kyriazisn/routine-quest/docs/03-wireframes.md

# 03 — Wireframes (Parent PWA & Device UI)

Status: **Draft — προς έγκριση**

Figma: https://www.figma.com/design/BA38FGH2zqvsLxBvpiYlAG

Low-fidelity wireframes: γκρι παλέτα, Inter, mobile frame 390×844. Τα χρώματα που εμφανίζονται είναι μόνο τα χρώματα των βημάτων και των LEDs, επειδή αποτελούν μέρος του concept.

## Σελίδες

| Σελίδα | Περιεχόμενο |
|---|---|
| Parent PWA | Components, Onboarding (O1–O5), Core (C1–C6) |
| Device UI | `Device` component, 7 καταστάσεις (D1–D7) |

## Local components

| Component | Χρήση |
|---|---|
| `Button/Primary`, `Button/Secondary` | Κύριες και δευτερεύουσες ενέργειες |
| `AppBar` | Πάνω μπάρα με leading εικονίδιο ή «←» |
| `TabBar` | Σήμερα · Ιστορικό · Rewards · Ρυθμίσεις |
| `ListRow` | Γραμμή λίστας με εικονίδιο, τίτλο, υπότιτλο, trailing |
| `Field` | Πεδίο φόρμας |
| `Card` | Κάρτα κειμένου |
| `StepDot` | Βήμα quest: χρωματιστός κύκλος + εικονίδιο |
| `Annotation` | Κίτρινη σημείωση σχεδιασμού κάτω από κάθε οθόνη |
| `Device` | Κάτοψη συσκευής: ring 12 LEDs + 4 κουμπιά |

Όταν στηθεί το design system, αυτά θα αντιστοιχηθούν σε components της PWA μέσω Code Connect.

## Parent PWA

### Onboarding

| # | Οθόνη | Βασική απόφαση |
|---|---|---|
| O1 | Καλωσόρισμα | Passwordless magic link. Λογαριασμός μόνο για ενήλικες |
| O2 | Εγκατάσταση & ειδοποιήσεις | Στο iOS: «Προσθήκη στην οθόνη Αφετηρίας» πριν το permission για Web Push |
| O3 | Σύνδεση συσκευής | Web Bluetooth. Fallback SoftAP `RQ-xxxx` για iOS Safari |
| O4 | Wi-Fi | Τα credentials πηγαίνουν μόνο στη συσκευή. Λίστα δικτύων από scan της συσκευής |
| O5 | Παιδί & πρώτα quests | Μόνο ψευδώνυμο + avatar. Έτοιμα πρότυπα πρωινού/βραδινού. Ζώνη ώρας |

### Core

| # | Οθόνη | User stories |
|---|---|---|
| C1 | Σήμερα | P3, P5 |
| C2 | Επεξεργασία quest | P2 |
| C3 | Ειδοποιήσεις | P3, P4 |
| C4 | Ιστορικό | P5 |
| C5 | Rewards | P6 |
| C6 | Ρυθμίσεις | P7, P8, P9, S4 |

## Device UI

| # | Κατάσταση | Ring | Κουμπιά | Ήχος |
|---|---|---|---|---|
| D1 | NEEDS_SETUP | Πορτοκαλί pulse | Σβηστά | — |
| D2 | SLEEPING (και EXPIRED/PAUSED) | Αστέρια εβδομάδας, αμυδρά | Σβηστά | Χαμηλό «μπιπ» σε πάτημα |
| D3 | ACTIVE | Αστέρια εβδομάδας | «Αναπνέουν» | Chime |
| D4 | IN_PROGRESS | Γέμισμα N/12 στο χρώμα level | Ολοκληρωμένα σταθερά + glow | Ανοδικό 2-note |
| D5 | UNDO | Αφαίρεση τμήματος | Fade 600 ms | Καθοδικό 2-note |
| D6 | COMPLETE | Γεμάτο, glow | Όλα αναμμένα | Μελωδία νίκης |
| D7 | TREASURE | Χρυσό σπινθήρισμα | Χρυσά | Ειδική μελωδία |

## Ανοιχτά θέματα για έγκριση

1. **Σταθερή αντιστοίχιση χρωμάτων κουμπιών.** Κόκκινο, μπλε, πράσινο, κίτρινο ανά θέση. Τα εικονίδια αλλάζουν με αυτοκόλλητα. Εναλλακτικά, το χρώμα θα μπορούσε να ορίζεται από τον γονέα.
2. **Ίδια 4 κουμπιά για πρωινό και βραδινό.** Τα κουμπιά είναι κοινά, άρα τα αυτοκόλλητα δεν ταιριάζουν και στις δύο ρουτίνες. Προτάσεις:
   - (α) Ουδέτερα αυτοκόλλητα αριθμών/σχημάτων και εικονίδιο στην app.
   - (β) Διπλό αυτοκόλλητο ☀️/🌙 ανά κουμπί.
   - (γ) Μαγνητικά εναλλάξιμα εικονίδια.

   Προτείνω (β) για το MVP. Επηρεάζει τη Φάση 6 (μηχανικός σχεδιασμός).
3. **Ζωντανή ενημέρωση στο C1.** SSE ή polling 15 s. Προτείνω SSE με fallback σε polling.
