kyriazisn/routine-quest/docs/02-game-design.md

# 02 — Core Game Loop, XP, Streaks, Rewards

Status: **Draft — προς έγκριση**

## 1. Αρχές σχεδιασμού

1. **Καμία τιμωρία.** Το παιδί δεν χάνει ποτέ XP ή αστέρια, και η συσκευή δεν δείχνει ποτέ «αποτυχία». Μια ρουτίνα που δεν ολοκληρώθηκε απλώς «πάει για ύπνο».
2. **Ό,τι βλέπει το παιδί είναι μετρήσιμο με τα μάτια.** Αριθμοί, XP και streak εμφανίζονται μόνο στον γονέα. Το παιδί βλέπει φως, χρώμα και ακούει μελωδία.
3. **Ντετερμινιστικές ανταμοιβές.** Κάθε πάτημα αποδίδει πάντα το ίδιο. Δεν υπάρχουν τυχαίες «εκπλήξεις» ή loot-box μηχανισμοί, που είναι dark pattern σε παιδικά προϊόντα.
4. **Ο γονέας κρατά τις υλικές ανταμοιβές.** Η συσκευή ανακοινώνει ότι «ο θησαυρός είναι έτοιμος». Τι είναι ο θησαυρός το αποφασίζει και το εγκρίνει ο γονέας.
5. **Σταδιακή απόσυρση εξωτερικών κινήτρων.** Το app προτείνει στον γονέα να αραιώνει τα rewards όταν η ρουτίνα σταθεροποιηθεί (≥ 3 εβδομάδες), για να περιοριστεί το overjustification effect.

## 2. Core loop

```
 Παράθυρο ρουτίνας ανοίγει
          │
          ▼
 Συσκευή «ξυπνά»: τα κουμπιά του quest αναβοσβήνουν απαλά
          │
          ▼
 Παιδί κάνει το βήμα ──► πατά το κουμπί
          │                   │
          │                   ├─ τοπικά: ήχος + κουμπί σταθερά αναμμένο + ring γεμίζει
          │                   └─ event ──► backend ──► (ρύθμιση) push στον γονέα
          ▼
 Όλα τα βήματα; ──όχι──► περιμένει επόμενο πάτημα
          │ναι
          ▼
 Animation νίκης + μελωδία  ──► +1 ⭐ (αστέρι)
          │
          ▼
 ⭐ ≥ κόστος reward; ──ναι──► «Θησαυρός» animation + push «reward έτοιμο» ──► γονέας εγκρίνει στην PWA
```

## 3. Quest state machine

Κάθε quest instance αντιστοιχεί σε μία ρουτίνα για μία ημερομηνία.

| State | Είσοδος | Τι δείχνει η συσκευή |
|---|---|---|
| `SLEEPING` | Εκτός παραθύρου | Ring σβηστό ή αμυδρό. Πάτημα → ήπιο animation «ύπνου», χωρίς event προόδου |
| `ACTIVE` | Άνοιγμα παραθύρου | Τα κουμπιά των βημάτων «αναπνέουν» στο χρώμα τους |
| `IN_PROGRESS` | ≥ 1 βήμα ολοκληρωμένο | Τα ολοκληρωμένα κουμπιά μένουν σταθερά αναμμένα. Το ring γεμίζει |
| `COMPLETE` | Όλα τα βήματα | Animation νίκης. Μετά από 30 s επιστρέφει σε χαμηλή φωτεινότητα |
| `EXPIRED` | Λήξη παραθύρου χωρίς ολοκλήρωση | Ίδιο με `SLEEPING`. Προς το παιδί δεν υπάρχει κανένα αρνητικό σήμα |
| `PAUSED` | Ο γονέας όρισε «ημέρα εκτός» | Ίδιο με `SLEEPING`. Δεν μετρά στο streak |

Μεταβάσεις:
- Undo (παρατεταμένο πάτημα ≥ 2 s) αφαιρεί το βήμα. Από `COMPLETE` επιστρέφει σε `IN_PROGRESS` και αφαιρεί το ⭐ της ολοκλήρωσης, αν δεν έχει εξαργυρωθεί.
- Η σειρά των βημάτων **δεν** επιβάλλεται στο MVP. Κάθε βήμα μετρά μία φορά ανά quest.

## 4. Οικονομία

### 4.1 XP (ορατό μόνο στον γονέα)

| Ενέργεια | XP |
|---|---|
| Βήμα ολοκληρώθηκε | +10 |
| Quest ολοκληρώθηκε (bonus) | +20 |
| Ημέρα με όλα τα quests ολοκληρωμένα | +20 |
| Undo | αναίρεση του αντίστοιχου XP (όχι ποινή) |

Δεν δίνεται bonus ταχύτητας. Η χρονική πίεση δεν ταιριάζει στις ηλικίες 4–7 και ενθαρρύνει πατήματα χωρίς να έχει γίνει το βήμα.

### 4.2 Levels (ορατά στο παιδί ως χρώμα)

Το επίπεδο εμφανίζεται ως το «χρώμα ήρωα» του ring σε idle και στο animation νίκης.

| Level | Συνολικό XP | Χρώμα ring |
|---|---|---|
| 1 | 0 | Λευκό |
| 2 | 150 | Πράσινο |
| 3 | 400 | Μπλε |
| 4 | 800 | Μωβ |
| 5 | 1400 | Χρυσό |
| 6+ | +800 ανά level | Χρυσό + «ουράνιο τόξο» στο level-up |

Με 2 quests × 3 βήματα την ημέρα, ένα παιδί κερδίζει περίπου 120 XP την ημέρα. Αυτό δίνει level 2 στη 2η μέρα, level 3 στην 4η, level 5 σε περίπου 2 εβδομάδες. Γρήγορη αρχική πρόοδος, πιο αραιή στη συνέχεια.

### 4.3 Αστέρια ⭐ (νόμισμα για rewards)

- +1 ⭐ ανά ολοκληρωμένο quest.
- Αθροίζονται και ξοδεύονται μόνο σε rewards που έχει ορίσει ο γονέας.
- Η συσκευή δείχνει στο παιδί **τα αστέρια της εβδομάδας**: ένα LED στο ring ανά ⭐, έως 12. Ο μετρητής μηδενίζεται Δευτέρα πρωί. Το πορτοφόλι αστεριών **δεν** μηδενίζεται.

### 4.4 Streak (ορατό μόνο στον γονέα)

- **Επιτυχημένη ημέρα:** όλα τα προγραμματισμένα quests της ημέρας είναι `COMPLETE`.
- **Μη μετρούμενη ημέρα:** ημέρες `PAUSED` ή χωρίς προγραμματισμένα quests δεν μετρούν και δεν σπάνε το streak.
- **Ασπίδα 🛡️:** 1 ανά εβδομάδα, εφαρμόζεται αυτόματα σε μία ανεπιτυχή ημέρα. Δεν συσσωρεύεται.
- Το παιδί δεν βλέπει ποτέ «σπασμένο streak». Βλέπει μόνο τα αστέρια της εβδομάδας.

### 4.5 Rewards

| Πεδίο | Παράδειγμα |
|---|---|
| Όνομα (για τον γονέα) | «Βόλτα στην παιδική χαρά» |
| Εικονίδιο | 🛝 (για να το δείξει ο γονέας στο παιδί στην PWA) |
| Κόστος | 5 ⭐ |
| Τύπος | Μία φορά / επαναλαμβανόμενο |

Ροή εξαργύρωσης:
1. Όταν το πορτοφόλι φτάσει το κόστος του **ενεργού** reward, η συσκευή παίζει animation «θησαυρού» και ο γονέας λαμβάνει push.
2. Ο γονέας πατά «Δόθηκε». Τα αστέρια αφαιρούνται και ενεργοποιείται το επόμενο reward.
3. Μόνο ένα ενεργό reward κάθε φορά. Το παιδί έχει έναν ξεκάθαρο στόχο.

Το app προτείνει μη υλικές ανταμοιβές: χρόνος με γονέα, επιλογή παραμυθιού, επιλογή φαγητού.

## 5. Χάρτης feedback συσκευής

| Event | Κουμπί LED | Ring | Ήχος |
|---|---|---|---|
| Παράθυρο ανοίγει | «Αναπνοή» στο χρώμα του βήματος | Αστέρια εβδομάδας, αμυδρά | Σύντομο «καλημέρα» chime (απενεργοποιήσιμο) |
| Βήμα ✓ | Σταθερό, φωτεινό | Γέμισμα +1/N με sweep | Ανοδικό 2-note |
| Undo | Σβήνει με fade | Αφαίρεση τμήματος | Καθοδικό 2-note, ήπιο |
| Quest ✓ | Όλα αναβοσβήνουν | Περιστροφή στο χρώμα level, μετά +1 αστέρι | Μελωδία νίκης ~2 s |
| Level up | — | Ουράνιο τόξο 3 s | Fanfare |
| Θησαυρός έτοιμος | — | Χρυσό «σπινθήρισμα» | Ειδική μελωδία |
| Πάτημα σε `SLEEPING` | Σύντομο αμυδρό flash | — | Πολύ σύντομο, χαμηλό |
| Offline (πάτημα) | Κανονικό feedback | Κανονικό | Κανονικό (sync αργότερα) |
| Χρειάζεται Wi-Fi / setup | — | Αργό πορτοκαλί pulse | — (το παιδί δεν χρειάζεται να καταλάβει) |

Ρυθμίσεις γονέα: ένταση (0–3), φωτεινότητα (αυτόματη νυχτερινή μείωση), σίγαση chime.

## 6. Anti-gaming χωρίς τιμωρία

| Σενάριο | Χειρισμός |
|---|---|
| Πατάει όλα τα κουμπιά σε < 10 s | Μετρούν κανονικά. Ο γονέας βλέπει ένδειξη «⚡ γρήγορο quest» στο ιστορικό, για κουβέντα, όχι για ποινή |
| Πατάει το ίδιο κουμπί ξανά | Αγνοείται (idempotent). Ήπιο flash επιβεβαίωσης |
| Bounce ή κράτημα κουμπιού | Debounce 30 ms. Το παρατεταμένο πάτημα σε ανολοκλήρωτο βήμα δεν κάνει τίποτα |
| Πολλαπλά κουμπιά ταυτόχρονα | Επεξεργάζονται με τη σειρά. Το combo 10 s για factory reset απαιτεί συγκεκριμένο συνδυασμό (κουμπιά 1+4) |
| Προαιρετικό «Parent check» | Ο γονέας μπορεί να επιβεβαιώνει την ολοκλήρωση στην PWA πριν δοθεί το ⭐. Default: off |

## 7. Χρόνος & edge cases

- Όλοι οι υπολογισμοί ημέρας γίνονται στη **ζώνη ώρας της οικογένειας** (IANA, π.χ. `Europe/Athens`), συμπεριλαμβανομένης της αλλαγής ώρας.
- Παράθυρα που περνούν τα μεσάνυχτα δεν υποστηρίζονται στο MVP (validation στην PWA).
- **Πηγή αλήθειας για XP, streak και αστέρια είναι το backend.** Η συσκευή εφαρμόζει τοπικά το ίδιο state machine για άμεσο feedback και κάνει reconcile στο sync.
- Το schedule αποθηκεύεται στη συσκευή (NVS), ώστε τα quests να λειτουργούν και offline. Ο χρόνος έρχεται από SNTP. Χωρίς έγκυρο χρόνο μετά από reboot, η συσκευή μπαίνει σε `SLEEPING` και δείχνει πορτοκαλί pulse.

## 8. Παράμετροι (configurable, server-side)

| Κλειδί | Default |
|---|---|
| `xp.step` | 10 |
| `xp.quest_bonus` | 20 |
| `xp.perfect_day` | 20 |
| `levels.thresholds` | [0,150,400,800,1400] (+800 μετά) |
| `undo.hold_ms` | 2000 |
| `reset.hold_ms` | 10000 |
| `debounce.ms` | 30 |
| `fast_quest.threshold_s` | 10 |
| `streak.shields_per_week` | 1 |
| `ring.week_reset` | Δευτέρα 00:00 local |
