kyriazisn/routine-quest/hardware/routine-quest.kicad_pcb

## KiCad design hardware/routine-quest.kicad_pcb (2026-10-13)

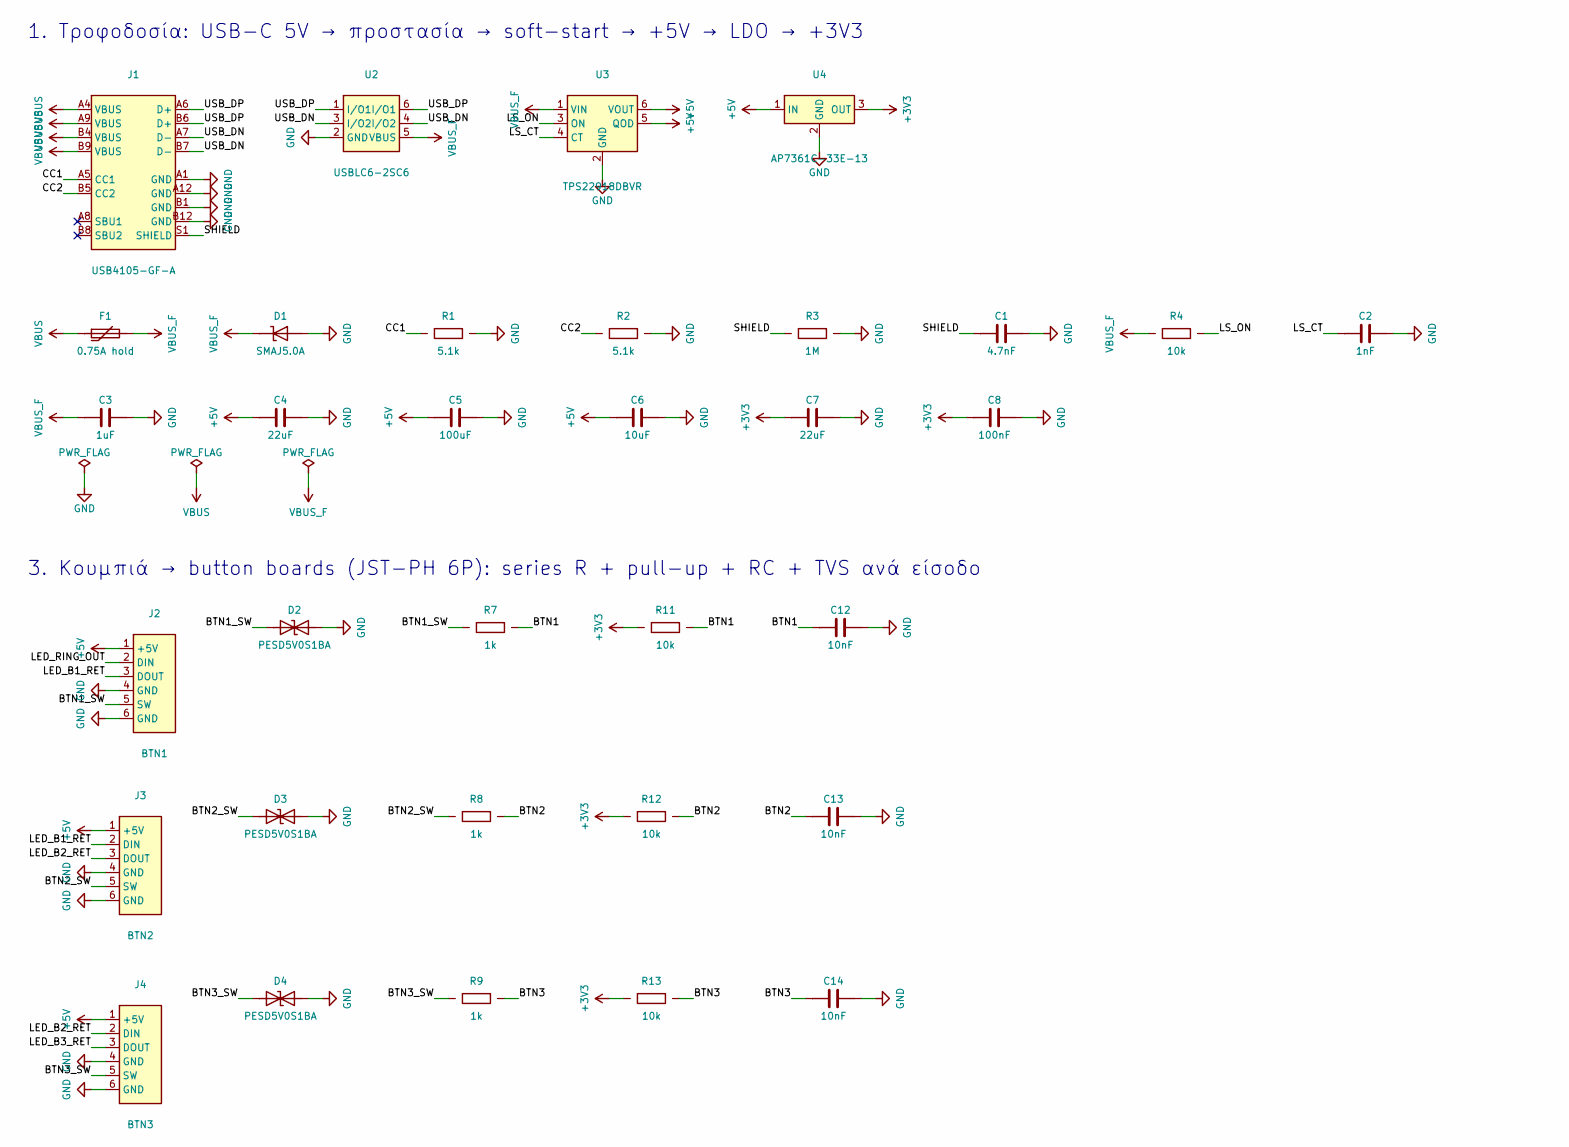
[picture p1: schematic routine-quest.kicad_sch, Routine Quest — Main board, part in row 1, column 1]

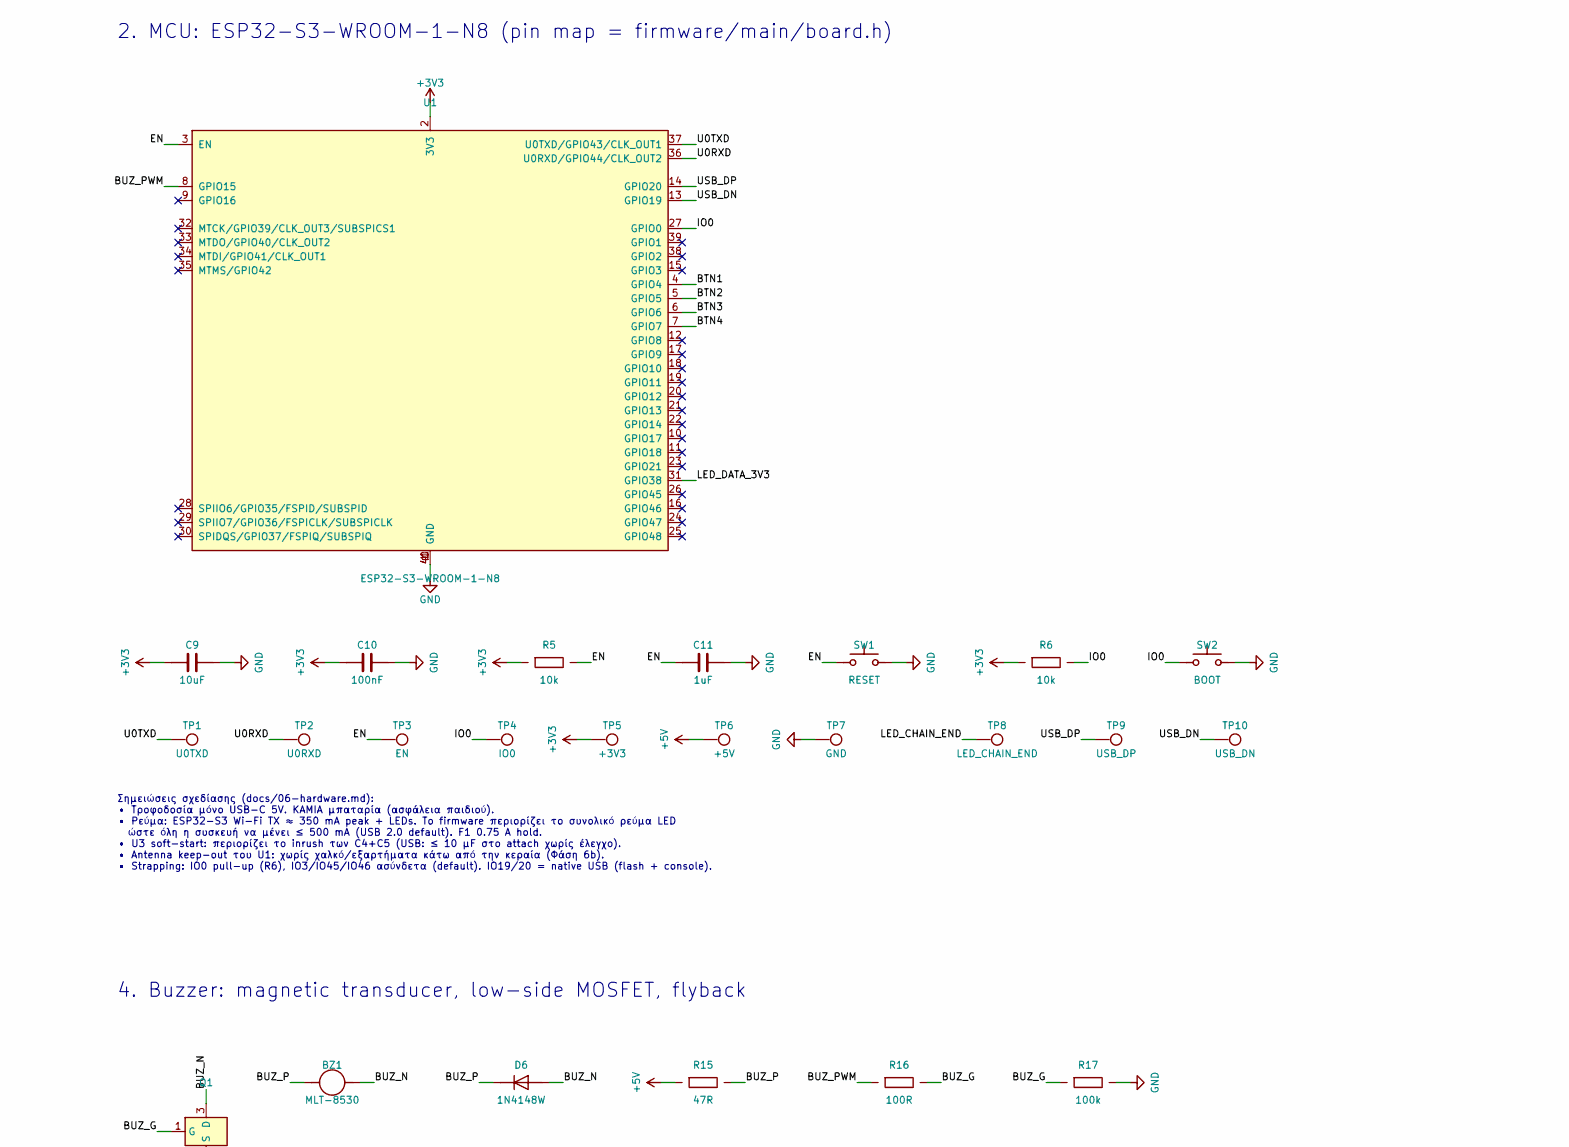
[picture p2: schematic routine-quest.kicad_sch, Routine Quest — Main board, part in row 1, column 2]

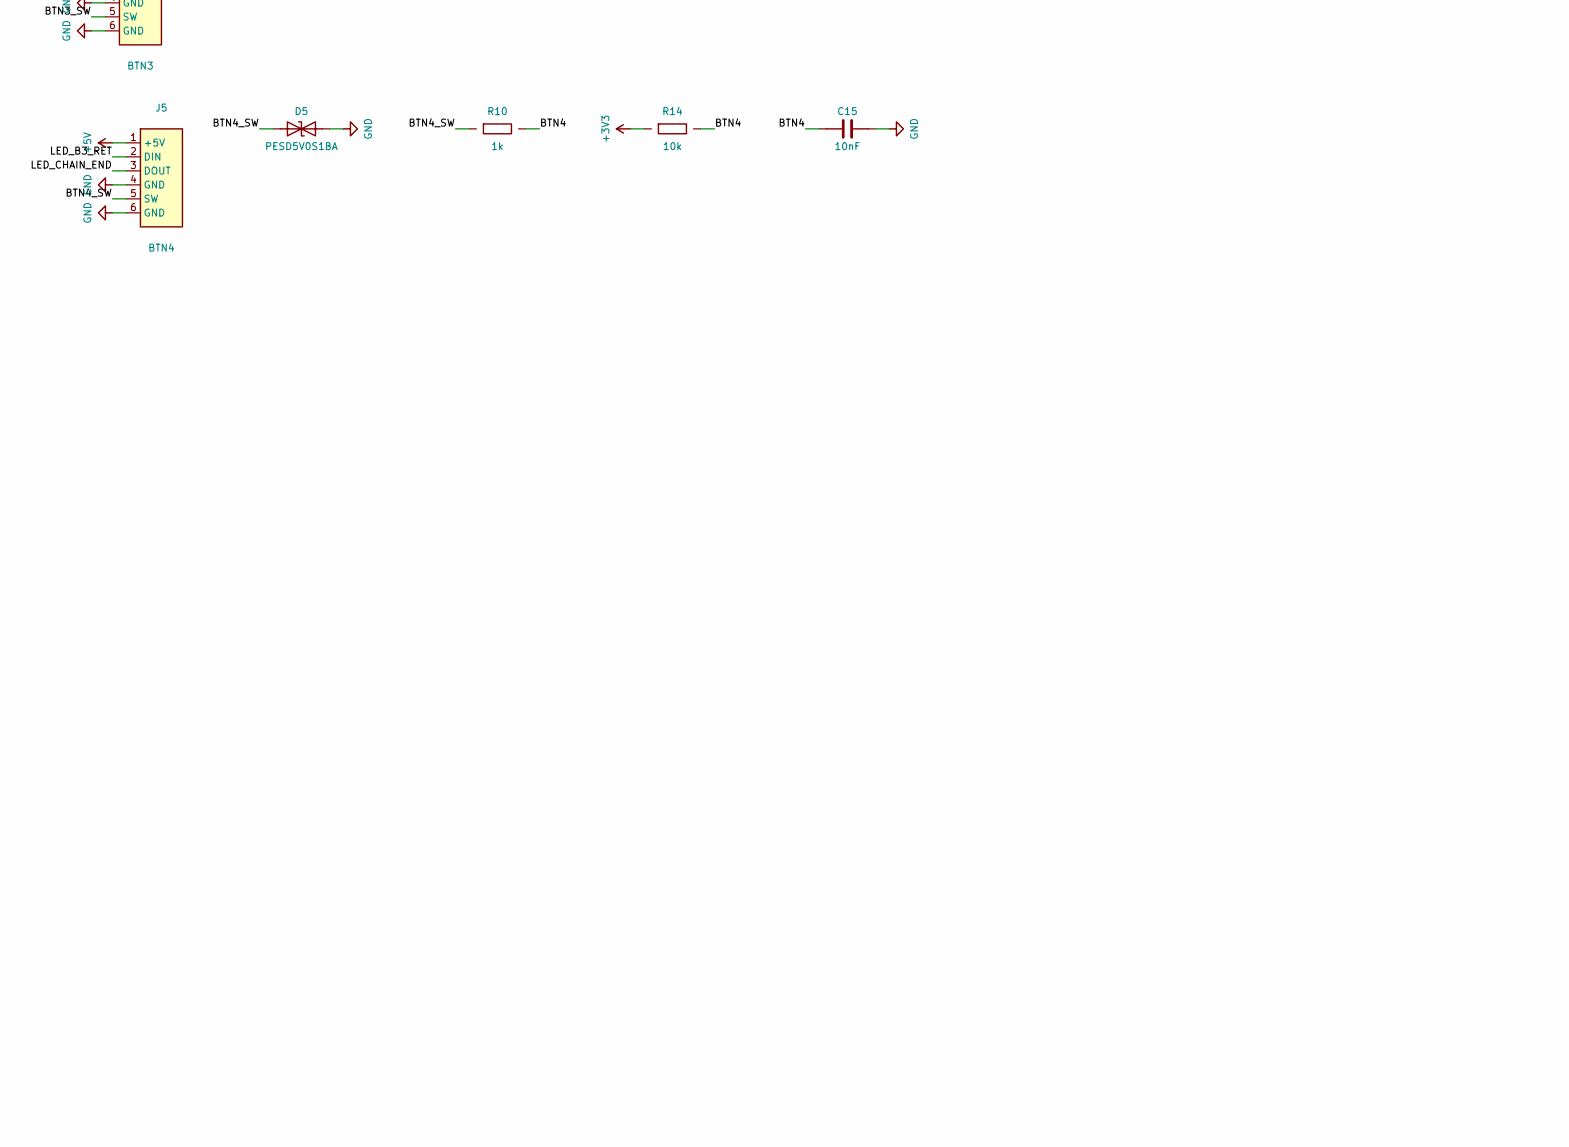
[picture p3: schematic routine-quest.kicad_sch, Routine Quest — Main board, part in row 2, column 1]

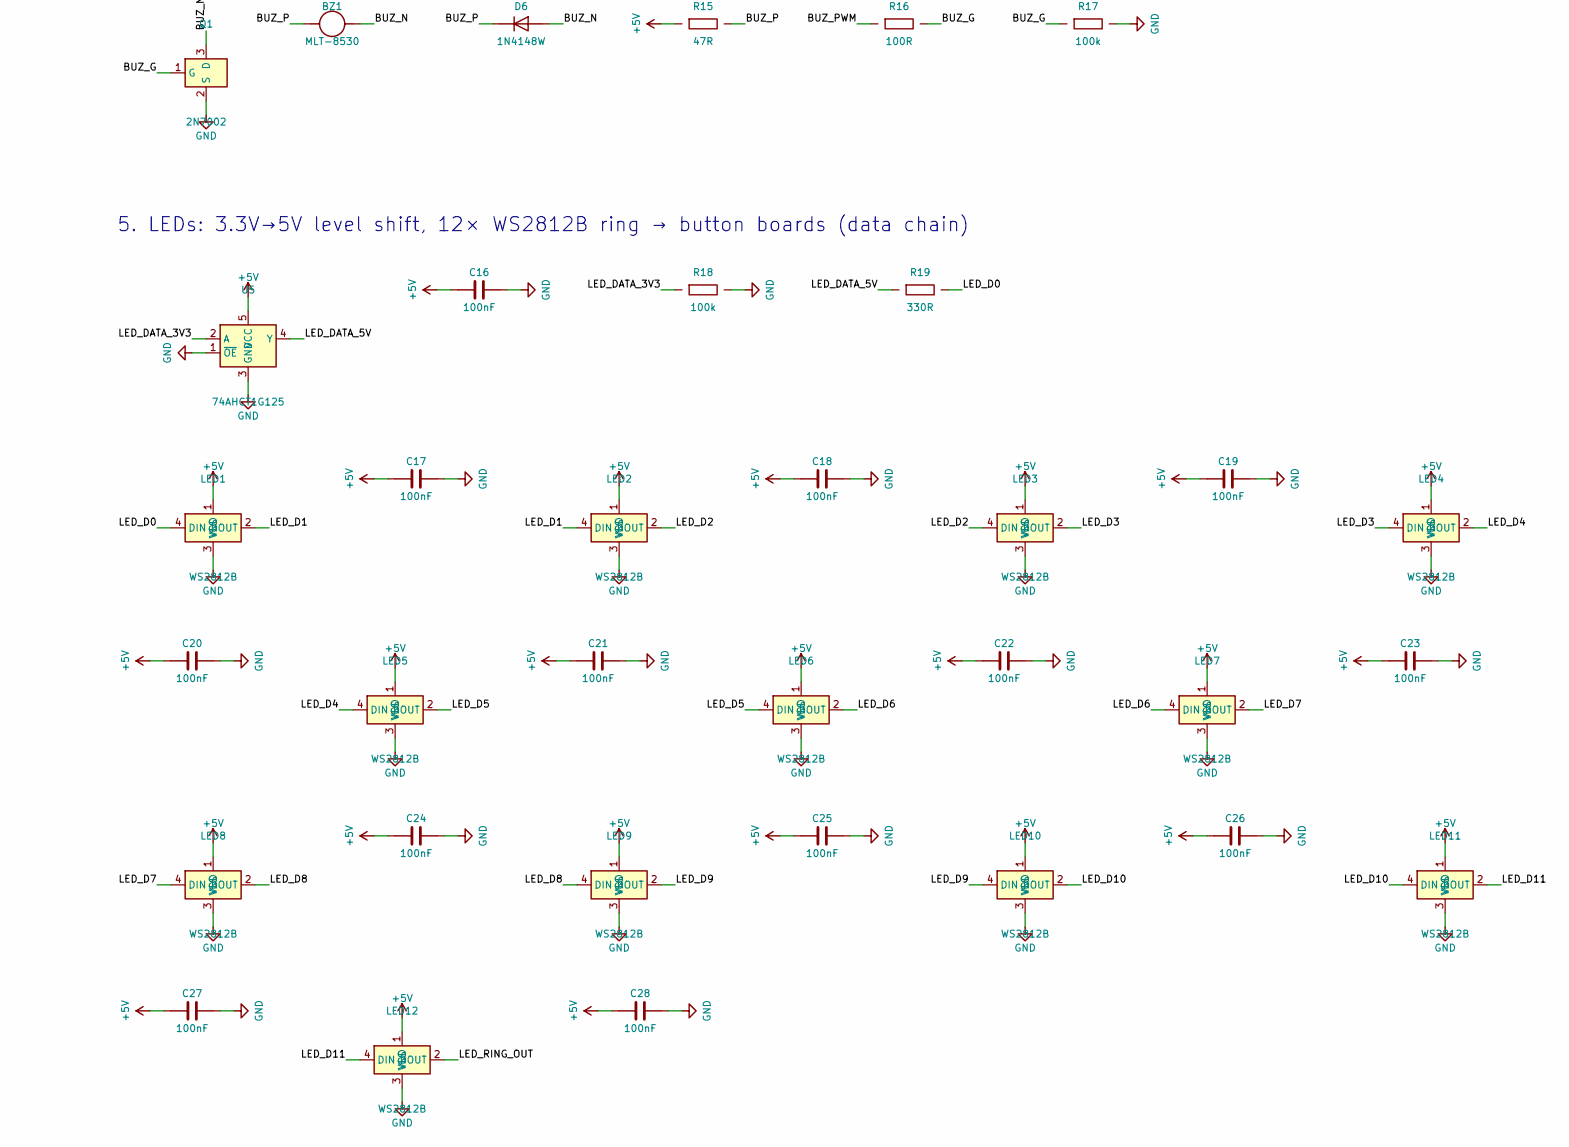
[picture p4: schematic routine-quest.kicad_sch, Routine Quest — Main board, part in row 2, column 2]

Parts:
BZ1: MLT-8530; Buzzer_MLT-8530; MPN MLT-8530
C1: 4.7nF; C_0603_1608Metric
C2: 1nF; C_0603_1608Metric
C3, C11: 1uF; C_0603_1608Metric
C4, C7: 22uF; C_0805_2012Metric
C5: 100uF; C_1210_3225Metric
C6, C9: 10uF; C_0805_2012Metric
C8, C10, C16, C17, C18, C19, C20, C21, C22, C23, C24, C25, C26, C27, C28: 100nF; C_0603_1608Metric
C12, C13, C14, C15: 10nF; C_0603_1608Metric
D1: SMAJ5.0A; D_SMA; MPN SMAJ5.0A
D2, D3, D4, D5: PESD5V0S1BA; D_SOD-323; MPN PESD5V0S1BA,115
D6: 1N4148W; D_SOD-123; MPN 1N4148W
F1: 0.75A hold; Fuse_1812_4532Metric; MPN MF-MSMF075-2
J1: USB4105-GF-A; USB_C_Receptacle_GCT_USB4105-xx-A_16P_TopMnt_Horizontal; MPN USB4105-GF-A
J2: BTN1; JST_PH_B6B-PH-K_1x06_P2.00mm_Vertical; MPN B6B-PH-K-S(LF)(SN)
J3: BTN2; JST_PH_B6B-PH-K_1x06_P2.00mm_Vertical; MPN B6B-PH-K-S(LF)(SN)
J4: BTN3; JST_PH_B6B-PH-K_1x06_P2.00mm_Vertical; MPN B6B-PH-K-S(LF)(SN)
J5: BTN4; JST_PH_B6B-PH-K_1x06_P2.00mm_Vertical; MPN B6B-PH-K-S(LF)(SN)
LED1, LED2, LED3, LED4, LED5, LED6, LED7, LED8, LED9, LED10, LED11, LED12: WS2812B; LED_WS2812B_PLCC4_5.0x5.0mm_P3.2mm; MPN WS2812B-B/W
Q1: 2N7002; SOT-23; MPN 2N7002
R1, R2: 5.1k; R_0603_1608Metric
R3: 1M; R_0603_1608Metric
R4, R5, R6, R11, R12, R13, R14: 10k; R_0603_1608Metric
R7, R8, R9, R10: 1k; R_0603_1608Metric
R15: 47R; R_1206_3216Metric
R16: 100R; R_0603_1608Metric
R17, R18: 100k; R_0603_1608Metric
R19: 330R; R_0603_1608Metric
SW1: RESET; SW_SPST_TL3342; MPN TL3342F160QG
SW2: BOOT; SW_SPST_TL3342; MPN TL3342F160QG
TP1: U0TXD; TestPoint_Pad_D1.5mm
TP2: U0RXD; TestPoint_Pad_D1.5mm
TP3: EN; TestPoint_Pad_D1.5mm
TP4: IO0; TestPoint_Pad_D1.5mm
TP5: +3V3; TestPoint_Pad_D1.5mm
TP6: +5V; TestPoint_Pad_D1.5mm
TP7: GND; TestPoint_Pad_D1.5mm
TP8: LED_CHAIN_END; TestPoint_Pad_D1.5mm
TP9: USB_DP; TestPoint_Pad_D1.5mm
TP10: USB_DN; TestPoint_Pad_D1.5mm
U1: ESP32-S3-WROOM-1-N8; ESP32-S3-WROOM-1; MPN ESP32-S3-WROOM-1-N8
U2: USBLC6-2SC6; SOT-23-6; MPN USBLC6-2SC6
U3: TPS22918DBVR; SOT-23-6; MPN TPS22918DBVR
U4: AP7361C-33E-13; SOT-223-3_TabPin2; MPN AP7361C-33E-13
U5: 74AHCT1G125; SOT-23-5; MPN SN74AHCT1G125DBVR

Connections:
+3V3: C7.1, C8.1, C9.1, C10.1, R5.1, R6.1, R11.1, R12.1, R13.1, R14.1, TP5.1, U1.2 (3V3), U4.3 (OUT)
+5V: C4.1, C5.1, C6.1, C16.1, C17.1, C18.1, C19.1, C20.1, C21.1, C22.1, C23.1, C24.1, C25.1, C26.1, C27.1, C28.1, J2.1 (+5V), J3.1 (+5V), J4.1 (+5V), J5.1 (+5V), LED1.1 (VDD), LED2.1 (VDD), LED3.1 (VDD), LED4.1 (VDD), LED5.1 (VDD), LED6.1 (VDD), LED7.1 (VDD), LED8.1 (VDD), LED9.1 (VDD), LED10.1 (VDD), LED11.1 (VDD), LED12.1 (VDD), R15.1, TP6.1, U3.5 (QOD), U3.6 (VOUT), U4.1 (IN), U5.5 (VCC)
BTN1: C12.1, R7.2, R11.2, U1.4 (GPIO4)
BTN1_SW: D2.1 (A1), J2.5 (SW), R7.1
BTN2: C13.1, R8.2, R12.2, U1.5 (GPIO5)
BTN2_SW: D3.1 (A1), J3.5 (SW), R8.1
BTN3: C14.1, R9.2, R13.2, U1.6 (GPIO6)
BTN3_SW: D4.1 (A1), J4.5 (SW), R9.1
BTN4: C15.1, R10.2, R14.2, U1.7 (GPIO7)
BTN4_SW: D5.1 (A1), J5.5 (SW), R10.1
BUZ_G: Q1.1 (G), R16.2, R17.1
BUZ_N: BZ1.2 (-), D6.2 (A), Q1.3 (D)
BUZ_P: BZ1.1 (+), D6.1 (K), R15.2
BUZ_PWM: R16.1, U1.8 (GPIO15)
CC1: J1.A5 (CC1), R1.1
CC2: J1.B5 (CC2), R2.1
EN: C11.1, R5.2, SW1.1, TP3.1, U1.3 (EN)
GND: C1.2, C2.2, C3.2, C4.2, C5.2, C6.2, C7.2, C8.2, C9.2, C10.2, C11.2, C12.2, C13.2, C14.2, C15.2, C16.2, C17.2, C18.2, C19.2, C20.2, C21.2, C22.2, C23.2, C24.2, C25.2, C26.2, C27.2, C28.2, D1.2 (A), D2.2 (A2), D3.2 (A2), D4.2 (A2), D5.2 (A2), J1.A1 (GND), J1.A12 (GND), J1.B1 (GND), J1.B12 (GND), J2.4 (GND), J2.6 (GND), J3.4 (GND), J3.6 (GND), J4.4 (GND), J4.6 (GND), J5.4 (GND), J5.6 (GND), LED1.3 (VSS), LED2.3 (VSS), LED3.3 (VSS), LED4.3 (VSS), LED5.3 (VSS), LED6.3 (VSS), LED7.3 (VSS), LED8.3 (VSS), LED9.3 (VSS), LED10.3 (VSS), LED11.3 (VSS), LED12.3 (VSS), Q1.2 (S), R1.2, R2.2, R3.2, R17.2, R18.2, SW1.2, SW2.2, TP7.1, U1.1 (GND), U1.40 (GND), U1.41 (GND), U2.2 (GND), U3.2 (GND), U4.2 (GND), U5.1 (~OE), U5.3 (GND)
IO0: R6.2, SW2.1, TP4.1, U1.27 (GPIO0)
LED_B1_RET: J2.3 (DOUT), J3.2 (DIN)
LED_B2_RET: J3.3 (DOUT), J4.2 (DIN)
LED_B3_RET: J4.3 (DOUT), J5.2 (DIN)
LED_CHAIN_END: J5.3 (DOUT), TP8.1
LED_D0: LED1.4 (DIN), R19.2
LED_D1: LED1.2 (DOUT), LED2.4 (DIN)
LED_D2: LED2.2 (DOUT), LED3.4 (DIN)
LED_D3: LED3.2 (DOUT), LED4.4 (DIN)
LED_D4: LED4.2 (DOUT), LED5.4 (DIN)
LED_D5: LED5.2 (DOUT), LED6.4 (DIN)
LED_D6: LED6.2 (DOUT), LED7.4 (DIN)
LED_D7: LED7.2 (DOUT), LED8.4 (DIN)
LED_D8: LED8.2 (DOUT), LED9.4 (DIN)
LED_D9: LED9.2 (DOUT), LED10.4 (DIN)
LED_D10: LED10.2 (DOUT), LED11.4 (DIN)
LED_D11: LED11.2 (DOUT), LED12.4 (DIN)
LED_DATA_3V3: R18.1, U1.31 (GPIO38), U5.2 (A)
LED_DATA_5V: R19.1, U5.4 (Y)
LED_RING_OUT: J2.2 (DIN), LED12.2 (DOUT)
LS_CT: C2.1, U3.4 (CT)
LS_ON: R4.2, U3.3 (ON)
SHIELD: C1.1, J1.S1 (SHIELD), R3.1
U0RXD: TP2.1, U1.36 (U0RXD/GPIO44/CLK_OUT2)
U0TXD: TP1.1, U1.37 (U0TXD/GPIO43/CLK_OUT1)
USB_DN: J1.A7 (D-), J1.B7 (D-), TP10.1, U1.13 (GPIO19), U2.3 (I/O2), U2.4 (I/O2)
USB_DP: J1.A6 (D+), J1.B6 (D+), TP9.1, U1.14 (GPIO20), U2.1 (I/O1), U2.6 (I/O1)
VBUS: F1.1, J1.A4 (VBUS), J1.A9 (VBUS), J1.B4 (VBUS), J1.B9 (VBUS)
VBUS_F: C3.1, D1.1 (K), F1.2, R4.1, U2.5 (VBUS), U3.1 (VIN)

Notes on the sheet:
1. Τροφοδοσία: USB-C 5V → προστασία → soft-start → +5V → LDO → +3V3
2. MCU: ESP32-S3-WROOM-1-N8 (pin map = firmware/main/board.h)
3. Κουμπιά → button boards (JST-PH 6P): series R + pull-up + RC + TVS ανά είσοδο
Σημειώσεις σχεδίασης (docs/06-hardware.md): • Τροφοδοσία μόνο USB-C 5V. ΚΑΜΙΑ μπαταρία (ασφάλεια παιδιού). • Ρεύμα: ESP32-S3 Wi-Fi TX ≈ 350 mA peak + LEDs. Το firmware περιορίζει το συνολικό ρεύμα LED ώστε όλη η συσκευή να μένει ≤ 500 mA (USB 2.0 default). F1 0.75 A hold. • U3 soft-start: περιορίζε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
4. Buzzer: magnetic transducer, low-side MOSFET, flyback
5. LEDs: 3.3V→5V level shift, 12× WS2812B ring → button boards (data chain)

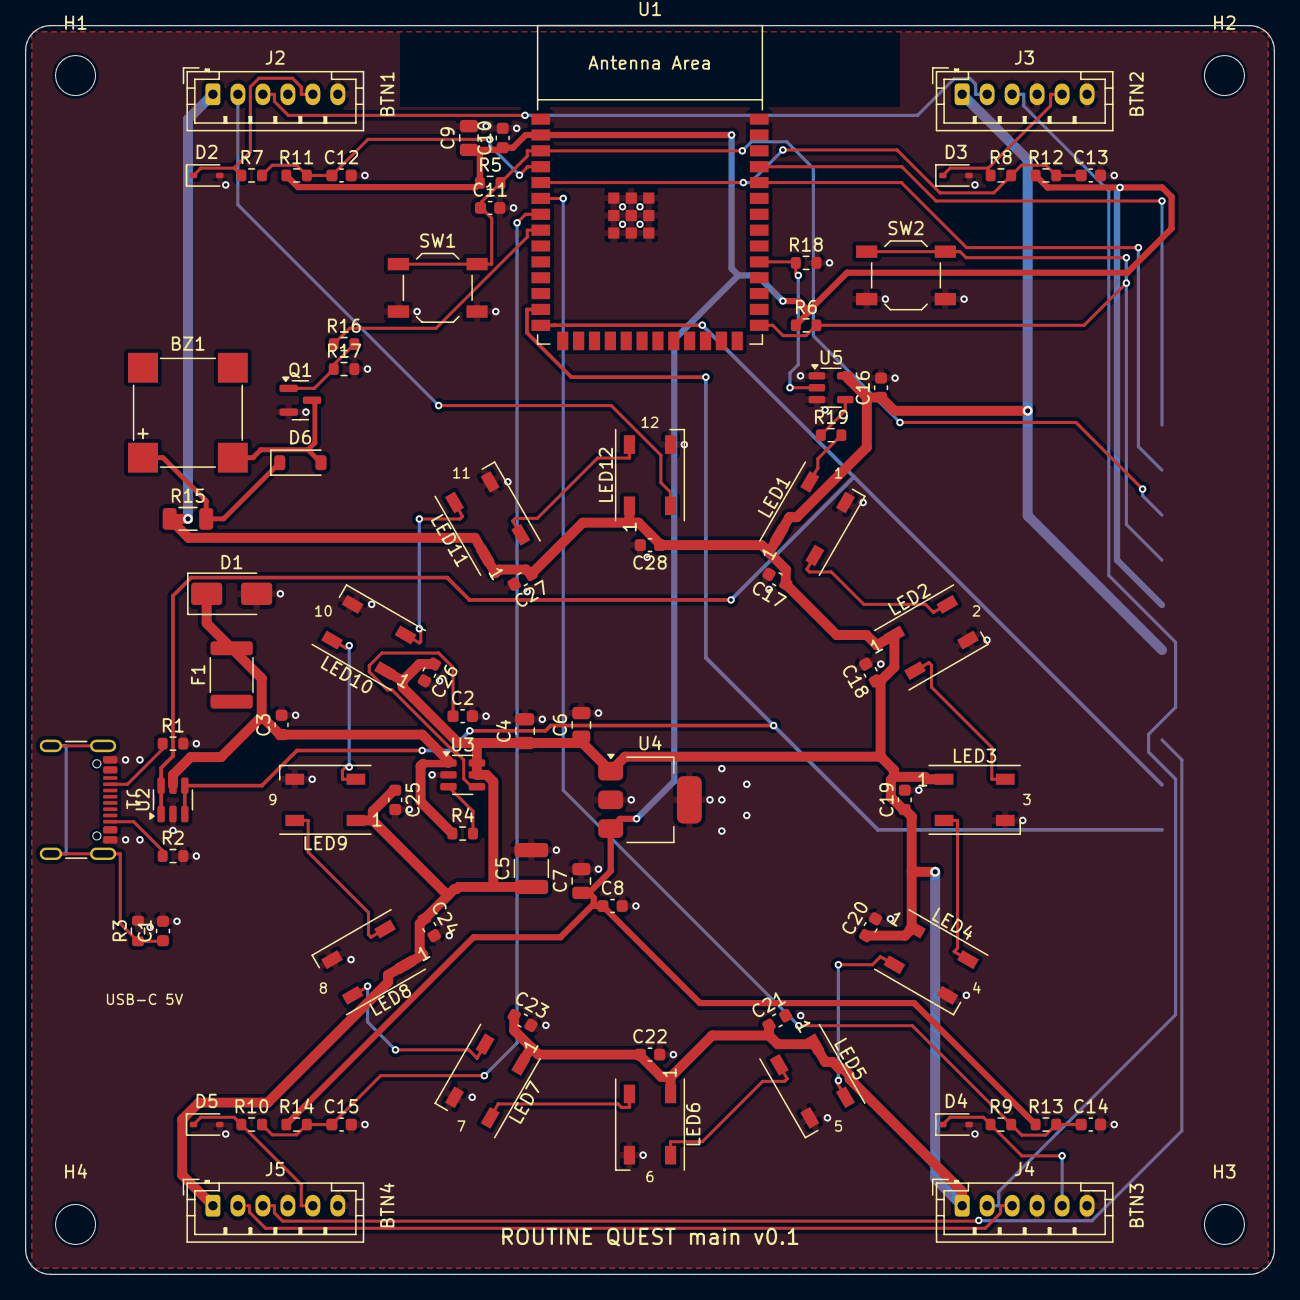
[picture p5: board routine-quest.kicad_pcb from above]

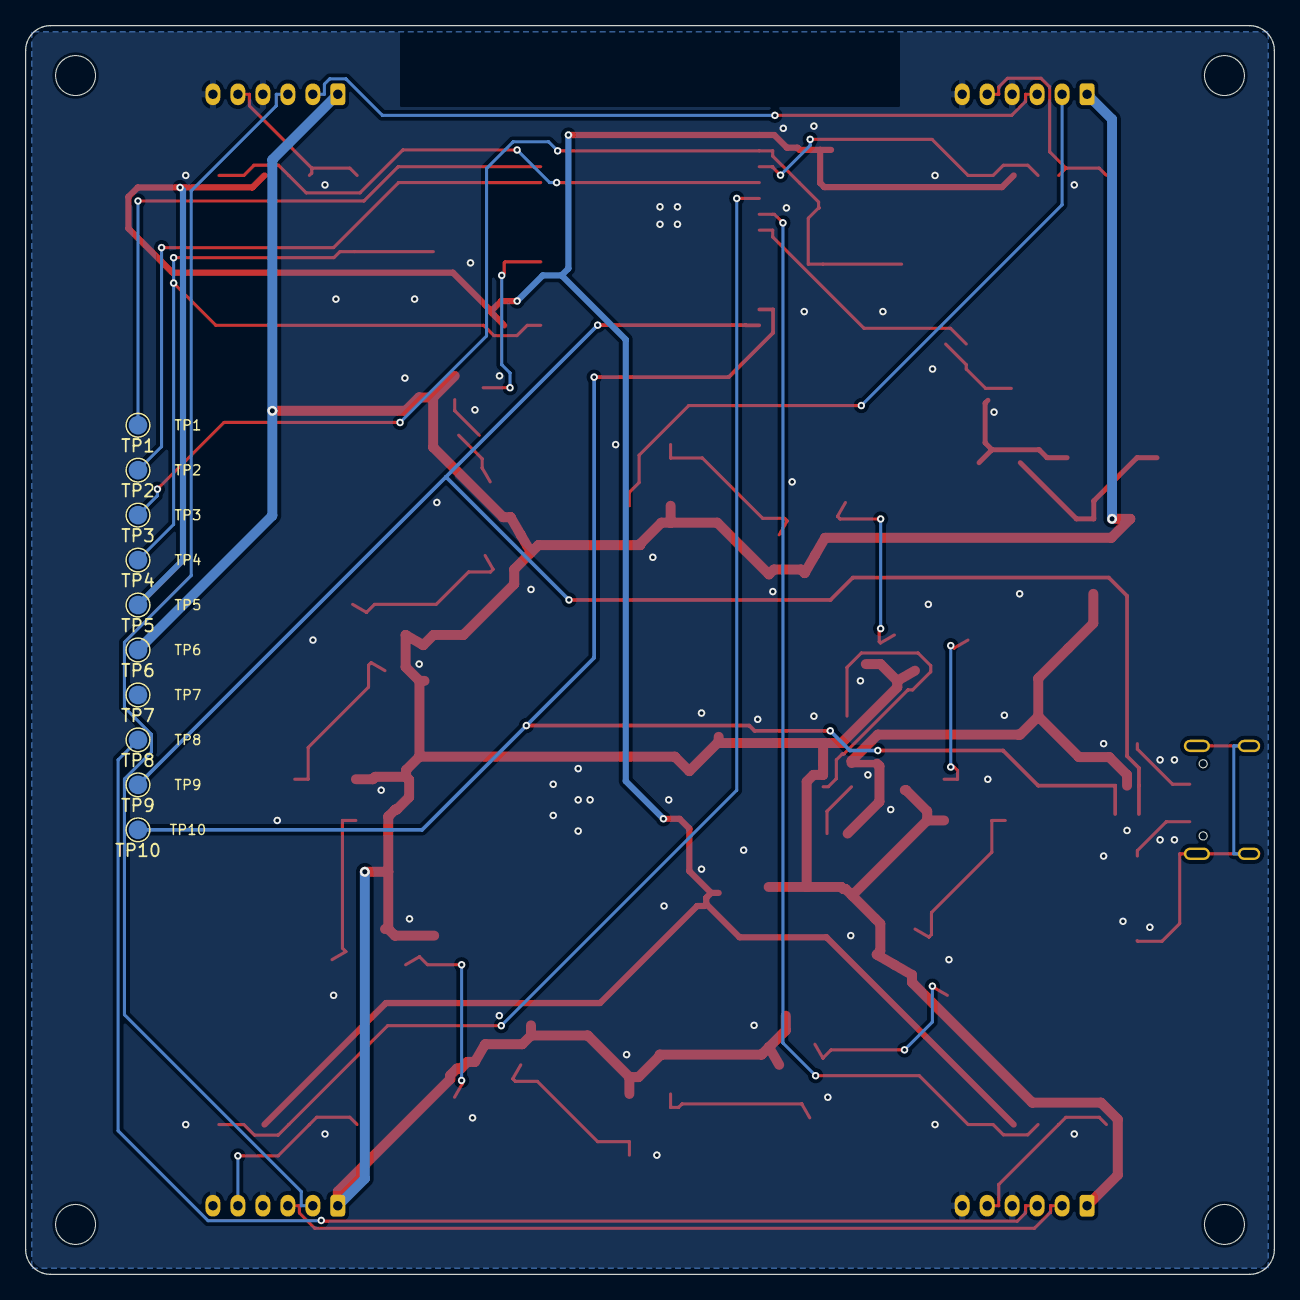
[picture p6: board routine-quest.kicad_pcb from below]

Board: 2 copper layers, 100.0 x 100.0 mm, 94 parts (10 on the bottom side), 47 nets.

Other parts of the board:
H1, H2, H3, H4: MountingHole; MountingHole_3.2mm_M3
