kyriazisn/routine-quest/hardware/button-board/button-board.kicad_pcb

## KiCad design hardware/button-board/button-board.kicad_pcb (2026-10-13)

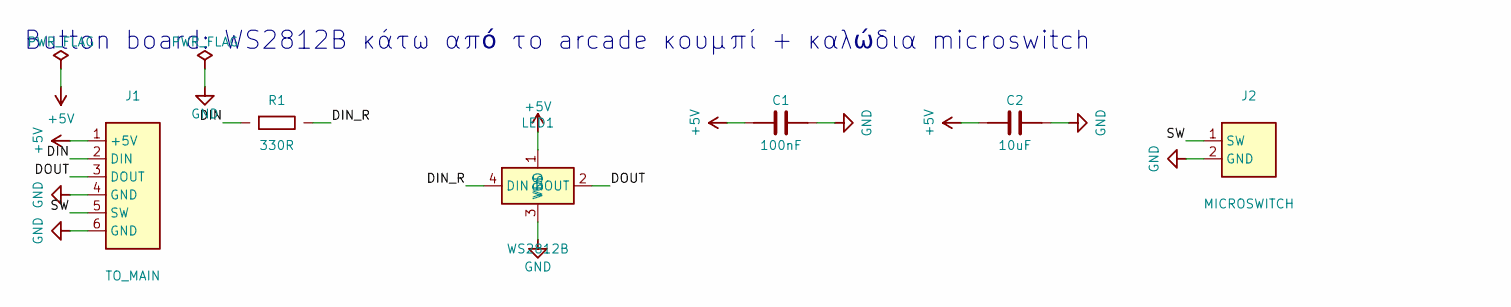
[picture p7: schematic button-board.kicad_sch, Routine Quest — Button board (×4)]

Parts:
C1: 100nF; C_0603_1608Metric
C2: 10uF; C_0805_2012Metric
J1: TO_MAIN; JST_PH_B6B-PH-K_1x06_P2.00mm_Vertical; MPN B6B-PH-K-S(LF)(SN)
J2: MICROSWITCH; JST_PH_B2B-PH-K_1x02_P2.00mm_Vertical; MPN B2B-PH-K-S(LF)(SN)
LED1: WS2812B; LED_WS2812B_PLCC4_5.0x5.0mm_P3.2mm; MPN WS2812B-B/W
R1: 330R; R_0603_1608Metric

Connections:
+5V: C1.1, C2.1, J1.1 (+5V), LED1.1 (VDD)
DIN: J1.2 (DIN), R1.1
DIN_R: LED1.4 (DIN), R1.2
DOUT: J1.3 (DOUT), LED1.2 (DOUT)
GND: C1.2, C2.2, J1.4 (GND), J1.6 (GND), J2.2 (GND), LED1.3 (VSS)
SW: J1.5 (SW), J2.1 (SW)

Notes on the sheet:
Button board: WS2812B κάτω από το arcade κουμπί + καλώδια microswitch

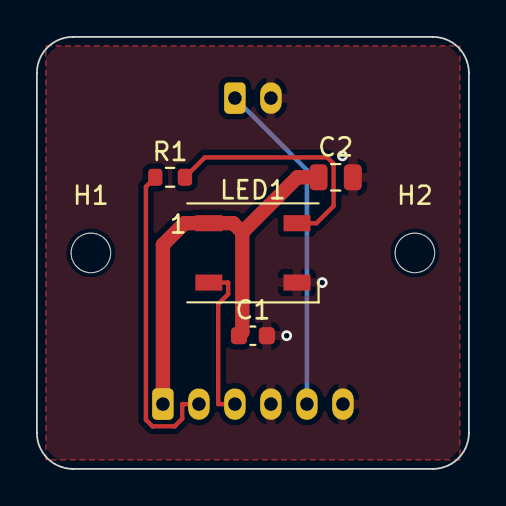
[picture p8: board button-board.kicad_pcb from above]

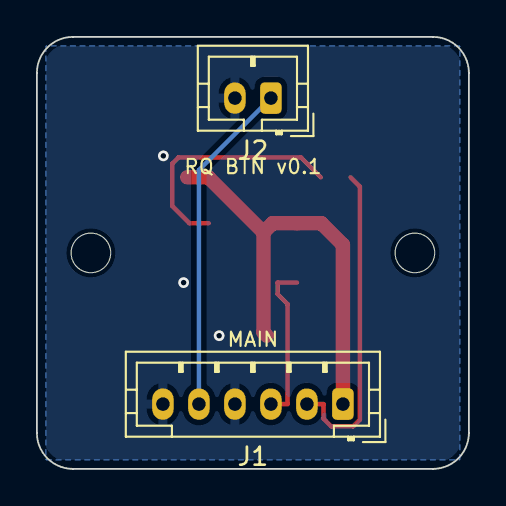
[picture p9: board button-board.kicad_pcb from below]

Board: 2 copper layers, 24.0 x 24.0 mm, 8 parts (2 on the bottom side), 6 nets.

Other parts of the board:
H1, H2: MountingHole; MountingHole_2.2mm_M2
