kyriazisn/routine-quest/(commit log)

2026-10-13 docs(design): add MVP wireframes for parent PWA and device states
    Claude-Session: https://claude.ai/code/session_018m2P3s8baNXUUh6XjxJz11
2026-10-13 feat(firmware): ESP32-S3 MVP firmware with quest engine, host tests and Wokwi simulation
    - pure-C quest engine (docs/02 state machine) with 57 host unit checks (ASan/UBSan)
    - buttons (debounce, long-press undo, reset combo), WS2812 + buzzer feedback
    - NVS storage with offline event ring and UUID idempotency keys
    - BLE provisioning with claim endpoint, SNTP, HTTPS cloud sync, OTA with rollback
    - CONFIG_RQ_SIM_MODE + Wokwi diagram and smoke scenario
    - CI: host tests, ESP-IDF v5.3.2 build, optional Wokwi job
    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
    [partitions.csv]
2026-10-13 fix(firmware): set 8 MB flash for Wokwi board and disable log colours in simulation
    Wokwi's ESP32-S3 DevKitC defaults to 4 MB flash, so the 8 MB partition table
    (ota_1 at 0x350000) failed verification and the bootloader reset in a loop.
    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
2026-10-13 feat(hardware): main board and button board schematics with BOM (v0.1, for review)
    - ESP32-S3-WROOM-1-N8 (official Espressif symbol), pin map unchanged from firmware
    - USB-C sink, PTC + TVS, USB ESD, TPS22918 soft-start, AP7361C LDO
    - 74AHCT1G125 level shift, 12 WS2812B ring + 4 button boards in one chain
    - buttons: TVS + series R + pull-up + RC; buzzer: 2N7002 + flyback
    - generator (source of truth), independent connectivity/ERC checker, PDF renderer
    - CI: regenerate-and-diff, checks, review PDF artifact
    - PCB layout intentionally not started (awaits schematic approval)
    Claude-Session: https://claude.ai/code/session_018m2P3s8baNXUUh6X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
    [button-board.csv, button-board.kicad_sch, main-board.csv, routine-quest.kicad_sch]
2026-10-13 docs(hardware): record schematic review decisions (ring on main board, 4 button boards, LED budget, buzzer tuning)
    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
2026-10-13 fix(hardware): make main schematic loadable in KiCad 9
    - escape newlines in string literals (raw newlines in the notes text broke the parser)
    - re-serialise the ESP32-S3-WROOM-1 symbol with our writer: kiutils mis-parsed the
    upstream KiCad 10 syntax (show_name, lost hide); pin data still from the official symbol
    - emit one stub per stacked pin location (module GND pads)
    - checker: KiCad 8 syntax lint (raw newlines, newer-version tokens, paren balance)
    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
    [routine-quest.kicad_sch]
2026-10-13 add: main and button erc
2026-10-13 feat(hardware): PCB layout WIP — placement, autorouting pipeline, checks (phase 6b)
    Work in progress, NOT for ordering (see docs/06b-pcb.md "Πού έμεινε").
    - gen_pcb.py: main board 100x100 mm 2L (ESP32 antenna at edge + keep-out, USB-C left edge,
    12-LED ring, LDO/load switch inside ring, JSTs in corners, bottom test pads), button board
    24x24 mm; net classes, design rules, GND pours, stitching vias; parts/nets from gen_schematics
    - route_pcb.py: Freerouting 1.9.0 via DSN/SES (own SES parser), zone fill, DRC report
    - check_pcb.py: board nets == schematic, DRC, antenna clearance, USB-C at edge
    - Footprints: new RQ:Buzzer_MLT-8530 (verify vs manufacturer drawing), vendored Espress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
    [button-board.kicad_pcb, main-board.csv, routine-quest.kicad_pcb, routine-quest.kicad_sch]
